banyanshade-software/BleAntRemote/README.md

# BleAntRemote
A bike remote control (to control Garmin GPS, GoPro, etc..) based on nRF5x MCU
