banyanshade-software/BleAntRemote/hardware/board/README.md

# GoPro / Garmin Edge Remote — KiCad Project

## State of this project
- **Schematic** (`gopro_garmin_remote.kicad_sch`): complete and **validated**.
  Generated programmatically then verified with `kicad-cli` (load OK, netlist
  export OK). All expected nets are correctly formed: `VBAT`, `GND`,
  `SWDIO`, `SWCLK`, `GPIO_CAM_ON`, `GPIO_CAM_OFF`, `GPIO_PAGE_R`, `GPIO_PAGE_L`,
  `GPIO_LAP`, `NTC_SENSE`. Only the module's `ANT` and `RESET` pins remain
  intentionally unconnected at this stage.
- **Module footprint** (`RemoteLocal.pretty/E73-2G4M08S1E_hand_solder.kicad_mod`):
  an extended-pad template (hand soldering), referenced by U1. **The radio
  module is not yet chosen** (shortlist in `doc/hardware_notes.md` §9:
  Fanstel BT832 / E73-2G4M08S1E (nRF52833, owned) / E73-2G4M04S1B); this
  footprint/symbol keep their old `E73-2G4M08S1E` filename but are only a
  placeholder to be replaced once the module is picked.
- **PCB**: not generated yet (see "Next steps").

## ⚠️ Out of sync: thermistor removed from the design
`NTC1`, `R1`, and the `NTC_SENSE` net below are from an earlier design
that used an external NTC thermistor for temperature. That was replaced
by the nRF52832's internal die temperature sensor (no external component)
— see `doc/gopro_garmin_remote_specs.md`, "Internal temperature sensor".
This schematic has **not been updated yet** to remove them — treat the
table below as describing the *previous* design for that part, and remove
`NTC1`/`R1`/`NTC_SENSE` during the next schematic edit.

## Schematic components

| Ref. | Description | Connected nets |
|---|---|---|
| U1 | Radio module (custom placeholder symbol, still named `E73-2G4M08S1E`; module TBD — see `doc/hardware_notes.md` §9) | VBAT, GND, SWDIO, SWCLK, GPIO_CAM_ON/OFF, GPIO_PAGE_R/L, GPIO_LAP, NTC_SENSE |
| BT1 | CR2032 coin cell | VBAT, GND |
| C1 | 100µF tantalum (decoupling) | VBAT, GND |
| C2 | 100nF ceramic (HF filtering) | VBAT, GND |
| SW1–SW5 | Push buttons (CAM_ON, CAM_OFF, PAGE_R, PAGE_L, LAP) | GND + dedicated GPIO |
| NTC1 | 10k thermistor | VBAT, NTC_SENSE |
| R1 | 10k fixed resistor (thermistor divider) | NTC_SENSE, GND |
| J1 | 4-pin SWD header | VBAT, SWDIO, SWCLK, GND |

## ⚠️ Points to check before fabrication

1. **Actual module pinout**: the `U1` symbol uses **placeholder pin numbers**
   (1–7, 10–15) that do NOT necessarily match any module's real physical
   pins. Before routing a PCB, pick the module (`doc/hardware_notes.md` §9)
   and re-align these numbers with its real pinout table (the per-module pin
   maps are in §9.7), or reuse a verified library symbol.
2. **Module footprint**: the footprint provided is an **educational template**
   (extended-pad technique demonstrated on 8 pins). It needs to be redone for
   the chosen module's real pads before routing the PCB.
3. **Schematic layout**: the labels are a bit visually cramped (generated by
   script, not by a human in the editor). The electrical connectivity is
   correct, but you'll likely want to rearrange the labels in KiCad for
   readability (Tools > nothing to recompute, just visual comfort).

## Suggested next steps

1. Remove `NTC1`, `R1`, and the `NTC_SENSE` net (superseded by the
   internal temperature sensor — see above).
2. Open `gopro_garmin_remote.kicad_pro` in KiCad 7+, review the schematic on
   screen, rearrange if needed.
3. Pick the module (hardware_notes §9) and complete its real pinout
   (symbol + footprint).
4. Switch to PCB mode (`Tools > Update PCB from Schematic`), place the
   components, route the traces.
5. Add the enclosure outline / mounting holes based on the chosen handlebar
   mount.

## Tools used to generate this project
- `kiutils` (Python) to write a syntactically valid `.kicad_sch`.
- `kicad-cli` 7.0.11 to validate loading and export the netlist/PDF.
- Symbols reused as-is from the standard KiCad libraries:
  `Device:R`, `Device:C`, `Device:Battery_Cell`, `Device:Thermistor_NTC`,
  `Switch:SW_Push`, `Connector_Generic:Conn_01x04`.
