banyanshade-software/BleAntRemote/doc/OtherSimilarRealisations.md

# To be checked

## GoPro command

* [Open GoPro](https://gopro.github.io/OpenGoPro/docs/)

* [github nrf52_gopro_zephyr](https://github.com/Sergey1560/nrf52_gopro_zephyr)
seems similar

## ANT

* [vieux github](https://github.com/Goordey/NRF52/tree/master/sdk/examples/ant/ant_broadcast)

* [ANT/ANT+](https://devzone.nordicsemi.com/f/nordic-q-a/32445/ant-ant-confusion-examples)
https://www.nordicsemi.com/Products/Wireless/ANT/Development-software

* https://www.nordicsemi.com/Products/Wireless/ANT/Development-software
