banyanshade-software/BleAntRemote/hardware/board/gopro_garmin_remote.kicad_sch

## KiCad design hardware/board/gopro_garmin_remote.kicad_sch (2026-08-22)

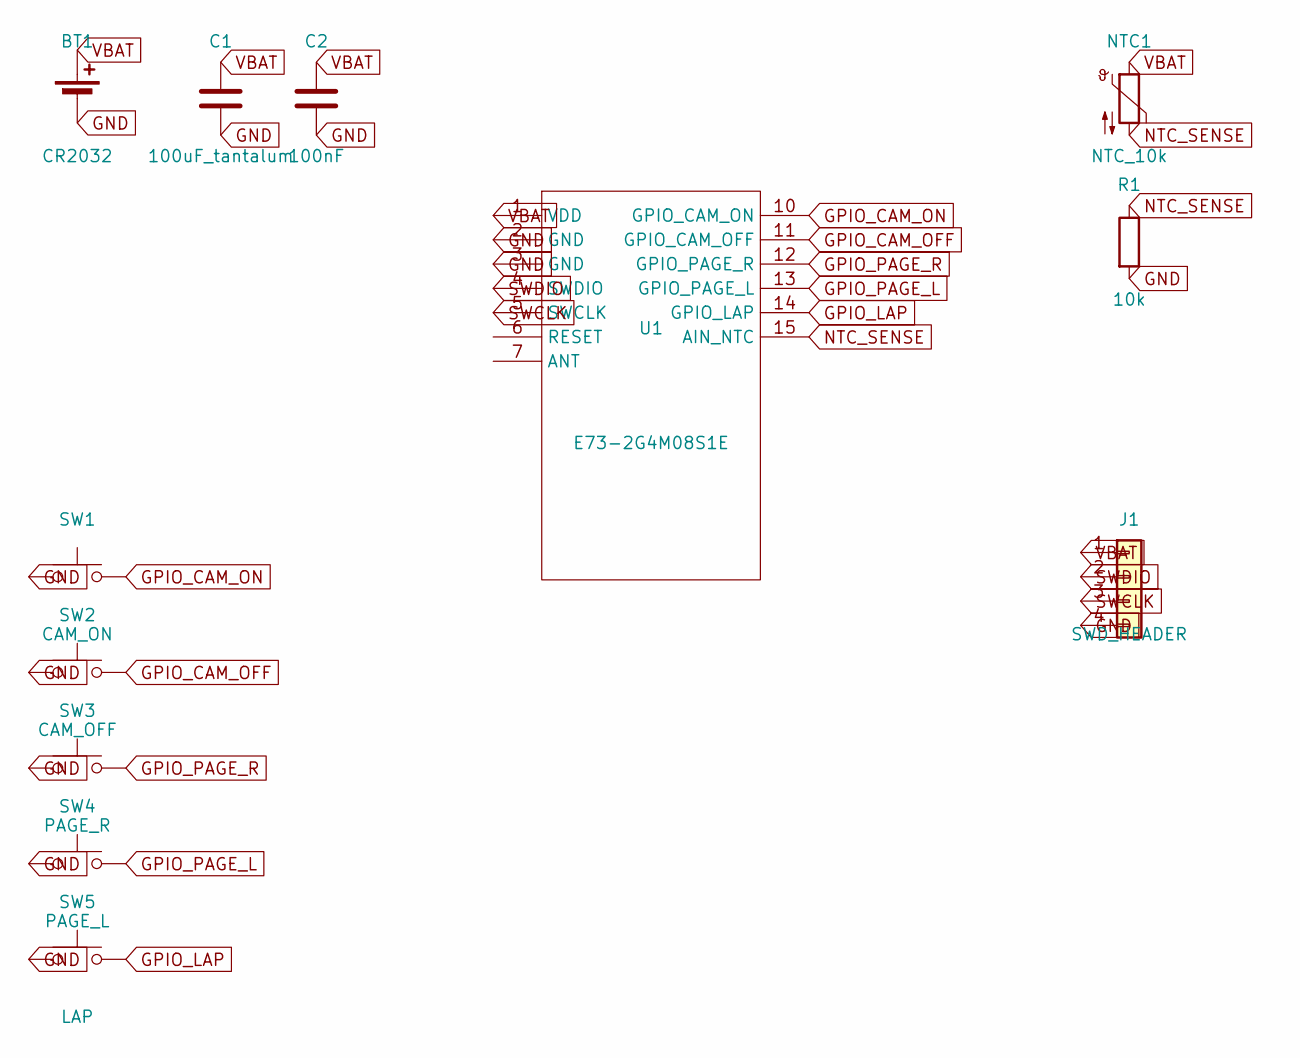
[picture p3: schematic gopro_garmin_remote.kicad_sch]

Parts:
BT1: CR2032
C1: 100uF_tantalum
C2: 100nF
J1: SWD_HEADER
NTC1: NTC_10k
R1: 10k
SW1: CAM_ON
SW2: CAM_OFF
SW3: PAGE_R
SW4: PAGE_L
SW5: LAP
U1: E73-2G4M08S1E; E73-2G4M08S1E_hand_solder

Connections:
GND: BT1.2 (-), C1.2, C2.2, J1.4, R1.2, SW1.1, SW2.1, SW3.1, SW4.1, SW5.1, U1.2 (GND), U1.3 (GND)
GPIO_CAM_OFF: SW2.2, U1.11 (GPIO_CAM_OFF)
GPIO_CAM_ON: SW1.2, U1.10 (GPIO_CAM_ON)
GPIO_LAP: SW5.2, U1.14 (GPIO_LAP)
GPIO_PAGE_L: SW4.2, U1.13 (GPIO_PAGE_L)
GPIO_PAGE_R: SW3.2, U1.12 (GPIO_PAGE_R)
NTC_SENSE: NTC1.2, R1.1, U1.15 (AIN_NTC)
SWCLK: J1.3, U1.5 (SWCLK)
SWDIO: J1.2, U1.4 (SWDIO)
VBAT: BT1.1 (+), C1.1, C2.1, J1.1, NTC1.1, U1.1 (VDD)
