banyanshade-software/BleAntRemote/software/gopro_remote_fw/src/main.c

/*
 * gopro_remote - bring-up firmware for the nRF52840 Dongle
 * ==========================================================
 *
 * This file owns the main finite-state machine: it wakes up on button
 * press, decides which action to run, and dispatches it to the
 * protocol-specific modules. It does not know about BLE or ANT+
 * internals - that logic lives in ble_gopro.[ch] (GoPro over BLE) and
 * ant_garmin.[ch] (Garmin Edge over ANT+, stub for now). temp_sensor.[ch]
 * provides the internal temperature reading; ant_garmin.c owns *when* to
 * read and broadcast it (a bounded, activity-triggered session - see
 * ant_garmin.h). main.c only reports "a button was pressed" via
 * ant_garmin_note_activity(), it does not manage the session itself.
 * This split keeps each radio protocol/sensor independently maintainable
 * and testable, and makes it straightforward to add a new module later
 * (e.g. a BLE peripheral "configuration service" for a companion mobile
 * app) without touching the others.
 *
 * What this firmware does (functional) :
 *   - Scans for and connects to a GoPro (filtering on the BLE service
 *     0xFEA6, advertised by Open GoPro compatible GoPros).
 *   - Performs bonding (secure pairing), required to talk to the
 *     GoPro. Keys are persisted to flash (CONFIG_SETTINGS), so
 *     subsequent connections won't need to re-pair.
 *   - Discovers the GP-0072/73 (Command/Response) and GP-0074/75
 *     (Query/Response) characteristics, subscribes to both.
 *   - Runs a small recording FSM (see the "Recording FSM" comment right
 *     above main()): "Camera ON"/"Camera OFF" (multi-button mode) or
 *     SW1 (mono-button toggle mode) drive it towards REC_ON/REC_OFF;
 *     the shutter=1/0 command is only sent on an actual on<->off
 *     transition, never repeated for an unchanged target, so it can't
 *     double-send the GoPro's confirmation beep. A ~1s status poll
 *     confirms the command took effect and also catches the camera
 *     being started/stopped manually (or disconnecting).
 *   - Buttons are debounced with a simple per-button cooldown.
 *
 * What this firmware does NOT do (to be added later) :
 *   - ANT+ (Garmin page right/left/lap buttons, and the temperature
 *     broadcast) : Nordic's Zephyr-based ANT+ add-on (`sdk-ant`) does
 *     support the nRF52832 used here (no chip change needed - see
 *     doc/gopro_garmin_remote_specs.md, "ANT+ implementation notes"),
 *     but getting ANT+ Adopter/GitHub access to the gated add-on repo
 *     and integrating its west workspace hasn't been done yet. Not
 *     included here. The Garmin buttons and the temperature broadcast
 *     are wired to stubs (see
 *     ant_garmin.c) in the meantime. The 3 Garmin buttons themselves
 *     are not wired to GPIOs/actions yet either (see README).
 *   - Fine-grained power management (System OFF between connections) :
 *     the dongle is USB-powered, so not critical for testing, but
 *     needs to be revisited for the final CR2032 version. Note this
 *     also now needs to account for the temperature broadcast session
 *     (see ant_garmin.h): while a session is active (up to
 *     TEMP_SESSION_DURATION_MIN minutes after the last button press),
 *     the MCU must wake periodically via its RTC/kernel timer to send
 *     a reading, so it cannot use full System OFF sleep during that
 *     window - only once the session ends does it go back to pure
 *     button-interrupt wake-up.
 *   - Battery voltage reading (ADC) : not wired on the bare dongle, to
 *     be added with the real enclosure. (Ambient temperature no longer
 *     needs a thermistor/ADC - see temp_sensor.c, which reads the
 *     nRF52's internal die temperature sensor instead.)
 *
 * Button GPIO pinout : see boards/nrf52840dongle_nrf52840.overlay
 */

#include <zephyr/kernel.h>
#include <zephyr/device.h>
#include <zephyr/devicetree.h>
#include <zephyr/drivers/gpio.h>
#include <zephyr/drivers/watchdog.h>
#include <zephyr/drivers/hwinfo.h>
#include <zephyr/logging/log.h>
#include <zephyr/settings/settings.h>

#include "ble_gopro.h"
#include "ant_garmin.h"
#include "temp_sensor.h"

//LOG_MODULE_REGISTER(gopro_remote, LOG_LEVEL_INF);
LOG_MODULE_REGISTER(gopro_remote, LOG_LEVEL_DBG);

/* -------------------------------------------------------------------
 * Buttons (gpio-keys via devicetree)
 * ------------------------------------------------------------------- */
#define BTN_CAM_ON_NODE  DT_ALIAS(sw_cam_on)
#define BTN_CAM_OFF_NODE DT_ALIAS(sw_cam_off)
#define BTN_SW1_NODE     DT_ALIAS(sw1)

/* Action queue processed outside of interrupt context. STATUS_TICK/
 * STATUS_RESULT are not button presses - see the status timer and
 * ble_gopro status callback further below - but they go through the
 * same queue so the FSM in main() stays single-threaded. */
enum rmt_event {
	EVENT_NONE = 0,
	EVENT_CAM_ON = 1,
	EVENT_CAM_OFF = 2,
	EVENT_BTN_SW1 = 3,
	EVENT_STATUS_TICK = 4,
	EVENT_STATUS_RES_CAM_ON = 5,
	EVENT_STATUS_RES_CAM_OFF = 6,
	EVENT_CAM_DISCOVERED = 7	, /* GoPro connected but not recording (e.g. just powered on) */
	EVENT_ANT_NEXT_PAGE = 8, /* SW1 short press -> ANT+ Controls "next page" (Menu Down) */
	EVENT_ANT_CUSTOM = 9,    /* SW1 long  press -> ANT+ Controls Custom (0x8000) */
};


 struct remote_msg {
        enum rmt_event action;
 };

K_MSGQ_DEFINE(action_msgq, sizeof(struct remote_msg), 8, 4);

/* -------------------------------------------------------------------
 * Buttons : ISR -> just posts an event to the queue, all the (BLE)
 * work happens in the main loop (normal thread).
 * ------------------------------------------------------------------- */



#define DEBOUNCE_MS 200
/* SW1 single-button: held >= LONG_PRESS_MS is a long press (Home),
 * otherwise a short press (next page). */
#define LONG_PRESS_MS 600
struct button {
	const struct gpio_dt_spec spec;
	enum rmt_event action;
	const char *name;
	struct gpio_callback cb;
	int64_t last_press_ms;
};

static   struct button btn_cam_on = {
	.spec = GPIO_DT_SPEC_GET(BTN_CAM_ON_NODE, gpios),
	.action = EVENT_CAM_ON,
	.name = "CAM_ON",
};
static  struct button btn_cam_off = {
	.spec = GPIO_DT_SPEC_GET(BTN_CAM_OFF_NODE, gpios),
	.action = EVENT_CAM_OFF,
	.name = "CAM_OFF",
};
static  struct button btn_sw1 = {
	.spec = GPIO_DT_SPEC_GET(BTN_SW1_NODE, gpios),
	.action = EVENT_BTN_SW1,
	.name = "SW1",
};

static void btn_isr(const struct device *dev, struct gpio_callback *cb, uint32_t pins)
{
	struct button *btn = CONTAINER_OF(cb, struct button, cb);
	int64_t now = k_uptime_get();

	if (now - btn->last_press_ms < DEBOUNCE_MS) {
		return; /* bounce (or a too-fast repeat press): ignore */
	}
	btn->last_press_ms = now;

	LOG_INF("Button %s pressed", btn->name);
	struct remote_msg msg = { .action = btn->action };

	k_msgq_put(&action_msgq, &msg, K_NO_WAIT);
}

/*
 * SW1 is the dongle's single user button. It needs short-vs-long press
 * discrimination:
 *   short press (< LONG_PRESS_MS) -> EVENT_ANT_NEXT_PAGE (Menu Down)
 *   long  press (>= LONG_PRESS_MS) -> EVENT_ANT_CUSTOM   (Custom 0x8000)
 *
 * Reading the pin level directly in the edge ISR is unreliable: contact
 * bounce produces bursts of edges, and a stray release edge used to clear
 * the press timestamp so the real release was dropped (long press missed).
 *
 * Instead the ISR only wakes a polling work item, which samples the button
 * every SW1_POLL_MS with a small debounce filter. The long press is emitted
 * as soon as the hold crosses LONG_PRESS_MS (even if the release bounces),
 * and the short press is emitted on a clean release. The ANT+ command is
 * sent from the main loop, not here.
 */
#define SW1_POLL_MS        20
#define SW1_STABLE_SAMPLES 2  /* consecutive equal reads to accept a level */

static void sw1_work_fn(struct k_work *work);
static K_WORK_DELAYABLE_DEFINE(sw1_work, sw1_work_fn);

static bool    sw1_down;        /* debounced pressed state */
static bool    sw1_long_fired;  /* HOME already emitted for this hold */
static int64_t sw1_down_ms;     /* uptime at debounced press */
static bool    sw1_raw_last;    /* last raw sample */
static int     sw1_stable_cnt;  /* consecutive equal raw samples */

static void sw1_post(enum rmt_event ev)
{
	struct remote_msg msg = { .action = ev };
	k_msgq_put(&action_msgq, &msg, K_NO_WAIT);
}

static void sw1_work_fn(struct k_work *work)
{
	ARG_UNUSED(work);
	bool raw = (gpio_pin_get_dt(&btn_sw1.spec) == 1); /* 1 = pressed */

	/* Debounce: require SW1_STABLE_SAMPLES equal raw reads in a row. */
	if (raw == sw1_raw_last) {
		if (sw1_stable_cnt < SW1_STABLE_SAMPLES) {
			sw1_stable_cnt++;
		}
	} else {
		sw1_raw_last = raw;
		sw1_stable_cnt = 0;
	}

	if (sw1_stable_cnt >= SW1_STABLE_SAMPLES && raw != sw1_down) {
		sw1_down = raw; /* debounced edge */
		if (sw1_down) {
			sw1_down_ms = k_uptime_get();
			sw1_long_fired = false;
		} else if (!sw1_long_fired) {
			sw1_post(EVENT_ANT_NEXT_PAGE); /* clean short release */
		}
	}

	/* Long press fires at the threshold, while still held. */
	if (sw1_down && !sw1_long_fired &&
	    (k_uptime_get() - sw1_down_ms) >= LONG_PRESS_MS) {
		sw1_long_fired = true;
		sw1_post(EVENT_ANT_CUSTOM);
	}

	/* Keep polling while pressed or not yet settled in the released state. */
	if (sw1_down || raw || sw1_stable_cnt < SW1_STABLE_SAMPLES) {
		k_work_schedule(&sw1_work, K_MSEC(SW1_POLL_MS));
	}
}

static void sw1_isr(const struct device *dev, struct gpio_callback *cb, uint32_t pins)
{
	ARG_UNUSED(dev);
	ARG_UNUSED(cb);
	ARG_UNUSED(pins);
	/* Just wake the poller; all logic lives in sw1_work_fn. */
	k_work_schedule(&sw1_work, K_NO_WAIT);
}

static int setup_sw1_button(void)
{
	int err;

	if (!gpio_is_ready_dt(&btn_sw1.spec)) {
		LOG_ERR("Button %s GPIO not ready", btn_sw1.name);
		return -ENODEV;
	}

	err = gpio_pin_configure_dt(&btn_sw1.spec, GPIO_INPUT);
	err |= gpio_pin_interrupt_configure_dt(&btn_sw1.spec, GPIO_INT_EDGE_BOTH);
	if (err) {
		LOG_ERR("Button %s GPIO configuration failed (%d)", btn_sw1.name, err);
		return err;
	}

	gpio_init_callback(&btn_sw1.cb, sw1_isr, BIT(btn_sw1.spec.pin));
	gpio_add_callback(btn_sw1.spec.port, &btn_sw1.cb);
	return 0;
}

static int setup_one_button( struct button *btn)
{
	int err;

	if (!gpio_is_ready_dt(&btn->spec)) {
		LOG_ERR("Button %s GPIO not ready", btn->name);
		return -ENODEV;
	}

	err = gpio_pin_configure_dt(&btn->spec, GPIO_INPUT);
	err |= gpio_pin_interrupt_configure_dt(&btn->spec, GPIO_INT_EDGE_TO_ACTIVE);
	if (err) {
		LOG_ERR("Button %s GPIO configuration failed (%d)", btn->name, err);
		return err;
	}

	gpio_init_callback(&btn->cb, btn_isr, BIT(btn->spec.pin));
	gpio_add_callback(btn->spec.port, &btn->cb);
	return 0;
}



static int setup_buttons(void)
{
	int err  = 0;
	err |= setup_one_button(&btn_cam_on);
	err |= setup_one_button(&btn_cam_off);
	err |= setup_sw1_button(); /* SW1: short/long press -> ANT+ commands */
	return err;
}

/* -------------------------------------------------------------------
 * ~1s status poll timer and ble_gopro status callback: both just post
 * to the action queue, all the FSM logic lives in main()'s loop below.
 * k_timer expiry and the BT RX thread are not the main thread, so this
 * is all they're allowed to do.
 * ------------------------------------------------------------------- */


static void status_timer_handler(struct k_timer *timer)
{
	struct remote_msg msg = { .action = EVENT_STATUS_TICK };
	//LOG_DBG("TTT isr");
	k_msgq_put(&action_msgq, &msg, K_NO_WAIT);
}


K_TIMER_DEFINE(status_timer, status_timer_handler, NULL);

static void on_gopro_status(enum gopro_rec_state status)
{
	LOG_DBG("on_gopro_status: status=%d", status);
	struct remote_msg msg = { 0 };
	switch (status) {
		case GOPRO_REC_STARTED:
			msg.action = EVENT_STATUS_RES_CAM_ON;
			break;
		case GOPRO_REC_STOPPED:
			msg.action = EVENT_STATUS_RES_CAM_OFF;
			break;
		case GOPRO_REC_DISCOVERED:
			msg.action = EVENT_CAM_DISCOVERED;
			break;
		case GOPRO_REC_UNKNOWN:
			LOG_DBG("on_gopro_status: GOPRO_REC_UNKNOWN - ignoring");
			return;
		default:
			LOG_ERR("on_gopro_status: unknown status %d", status);
			return;
	}
	k_msgq_put(&action_msgq, &msg, K_NO_WAIT);
}

/*
 * Recording FSM states (the whole FSM lives in main()'s loop below):
 *   REC_OFF      - not recording, idle.
 *   REC_ON_SENT  - "start recording" sent, waiting for the camera to
 *                  confirm it (via the ~1s status poll).
 *   REC_ON       - camera confirmed it is recording.
 *   REC_OFF_SENT - "stop recording" sent, waiting for confirmation.
 * No other state is needed: ON_SENT/OFF_SENT only exist to remember
 * "a command is outstanding" so a same-direction button press can be
 * ignored (that's what stops the BLE "start recording" command from
 * ever being sent twice in a row, which is what makes the camera beep
 * an extra time) - REC_ON/REC_ON_SENT together mean "target: on",
 * REC_OFF/REC_OFF_SENT together mean "target: off".
 */
enum rec_state {
	REC_UNKNOWN = 0,
	REC_OFF,
	REC_ON_SENT,
	REC_ON,
	REC_OFF_SENT,
};

/* from blinky */


/* 1000 msec = 1 sec */
#define SLEEP_TIME_MS   1000

/* The devicetree node identifier for the "led0" alias. */
#define LED0_NODE DT_ALIAS(led0)

/*
 * A build error on this line means your board is unsupported.
 * See the sample documentation for information on how to fix this.
 */
static const struct gpio_dt_spec led = GPIO_DT_SPEC_GET(LED0_NODE, gpios);

/* Hardware watchdog: an independent peripheral that keeps counting
 * down even if the CPU truly locks up (fault-in-fault, IRQs wedged
 * off, etc.) - the one thing that can still recover us and tell us
 * something when even the fatal-error handler can't print anything.
 * Armed with a long window, then deliberately NOT fed across the
 * ble_gopro_init()/bt_enable() call: if that call locks up, the
 * watchdog fires on its own a few seconds later and resets the chip. */
static const struct device *const wdt = DEVICE_DT_GET(DT_ALIAS(watchdog0));
static int wdt_channel_id = -1;

static void log_reset_cause(void)
{
	uint32_t cause = 0;

	if (hwinfo_get_reset_cause(&cause) == 0) {
		LOG_INF("Reset cause: 0x%08x%s", cause,
			(cause & RESET_WATCHDOG) ? " <-- WATCHDOG: previous boot locked up here!" : "");
		hwinfo_clear_reset_cause();
	} else {
		LOG_WRN("hwinfo_get_reset_cause() failed");
	}
}

static void watchdog_arm(void)
{
	if (!device_is_ready(wdt)) {
		LOG_WRN("Watchdog device not ready - no lockup recovery this run");
		return;
	}

	struct wdt_timeout_cfg wdt_cfg = {
		.window.min = 0,
		.window.max = 5000, /* must be fed at least every 5s */
		.callback = NULL,
		.flags = WDT_FLAG_RESET_SOC,
	};

	wdt_channel_id = wdt_install_timeout(wdt, &wdt_cfg);
	if (wdt_channel_id < 0) {
		LOG_ERR("wdt_install_timeout() failed (%d)", wdt_channel_id);
		return;
	}
	if (wdt_setup(wdt, 0) != 0) {
		LOG_ERR("wdt_setup() failed");
		wdt_channel_id = -1;
	}
}

static void watchdog_feed(void)
{
	if (wdt_channel_id >= 0) {
		wdt_feed(wdt, wdt_channel_id);
	}
}

/* Heartbeat: fast LED toggle while a blocking init call (e.g.
 * ble_gopro_init()/bt_enable()) is in progress. No debugger/console
 * available on the bare dongle, so this is how we tell "it's still
 * alive and hasn't returned yet" from "it froze/hard-faulted right
 * here": if this stops toggling and NEVER resumes (no fatal() blink
 * pattern ever starts either), the crash happened inside that call. */
static void heartbeat_handler(struct k_timer *timer)
{
	gpio_pin_toggle_dt(&led);
}
K_TIMER_DEFINE(heartbeat_timer, heartbeat_handler, NULL);

/* Halts and blinks the LED abs(code) times (capped), pausing between
 * repeats, so the code can be read off by counting blinks - no
 * debugger/console needed. Distinguishable from the heartbeat above
 * because of the long pause between bursts. */
static void fatal(int code)
{
	LOG_ERR("Fatal error %d - halting", code);

	int blinks = code < 0 ? -code : code;
	if (blinks == 0) {
		blinks = 1;
	}
	if (blinks > 20) {
		blinks = 20;
	}

	while (1) {
		for (int i = 0; i < blinks; i++) {
			watchdog_feed(); /* fatal() is a deliberate halt, not a
					   * real lockup - don't let the watchdog
					   * reset us out of it. */
			gpio_pin_set_dt(&led, 1);
			k_msleep(200);
			gpio_pin_set_dt(&led, 0);
			k_msleep(200);
		}
		k_msleep(1500);
	}
}
/* -------------------------------------------------------------------
 * main - button/action finite-state machine
 * ------------------------------------------------------------------- */
int main(void)
{
	int err;

	log_reset_cause();

	LOG_INF("=== GoPro Remote (nRF52840 Dongle) - starting ===");

	if (!gpio_is_ready_dt(&led)) {
		LOG_ERR("LED GPIO not ready");
		fatal(1);
	}
	err = gpio_pin_configure_dt(&led, GPIO_OUTPUT_INACTIVE);
	if (err < 0) {
		LOG_ERR("LED GPIO configuration failed (%d)", err);
		fatal(2);
	}

	if ((0)) watchdog_arm();

	/* LED toggles here independently of LOG_INF, so it keeps proving
	 * the CPU is alive even if the console/USB link itself stalls
	 * (e.g. CDC ACM backpressure) and stops printing. */
	const int startup_blink_count = 2;	
	for (int i=0; i<startup_blink_count; i++) {
		watchdog_feed();
		gpio_pin_toggle_dt(&led);
		LOG_INF("=== GoPro Remote (nRF52840 Dongle) - starting (%d/%d) ***", i, startup_blink_count);
		k_msleep(1000);
	}
	LOG_INF("compile date: %s", __DATE__);


	
	LOG_INF("=== config BLE---->");

/*
	err = settings_subsys_init();
	if (err) {
		LOG_ERR("settings_subsys_init() failed (%d)", err);
		fatal(err);
	}
*/	
	watchdog_feed(); /* last feed before the risky call - deliberately
			   * not fed again until it returns, so a lockup in
			   * here forces a watchdog reset within ~5s. */
	k_timer_start(&heartbeat_timer, K_MSEC(150), K_MSEC(150));
	err = ble_gopro_init();
	LOG_INF("=== config BLE done, err=%d", err);

	k_timer_stop(&heartbeat_timer);
	watchdog_feed();

	if (err) {
		LOG_ERR("ble_gopro_init() failed (%d)", err);
		fatal(err);
	}
	//fatal(420);

	err = setup_buttons();
	if (err) {
		LOG_ERR("Aborting: buttons not functional");
		fatal(3);
	}
	LOG_INF("**** ANT init");
	ant_garmin_init();

	LOG_INF("**** temp_sensor init");

	err = temp_sensor_init();
	if (err) {
		LOG_WRN("Internal temperature sensor unavailable (%d)", err);
	}
	LOG_INF("**** ANT init done");


	ble_gopro_set_status_cb(on_gopro_status);
	//k_timer_init(&status_timer, status_timer_handler, NULL);
	//LOG_DBG("TTT Starting status timer (1s period)");
	//k_timer_start(&status_timer, K_SECONDS(1), K_SECONDS(1));

	enum rec_state rec_state = REC_UNKNOWN; /* start unknown, will be set by the first status poll */
	bool status_query_sent = false; /* at most one status query outstanding */

	/* Main loop: wait for a button/status action and run the
	 * recording FSM. Each protocol module (ble_gopro, ant_garmin)
	 * manages its own connection/reconnection state internally. */
	struct remote_msg msg;
	while (1) {
		gpio_pin_toggle_dt(&led);

		k_msgq_get(&action_msgq, &msg, K_FOREVER);

		enum rmt_event action = msg.action;

		if (EVENT_BTN_SW1 == action) {
			switch (rec_state) {
				case REC_UNKNOWN:	//FALLTHRU
				case REC_ON_SENT:	//FALLTHRU
				case REC_OFF_SENT:	//FALLTHRU
				default:
					/* ignore button presses until we know the camera's state (via the status poll) */
					break;
				case REC_OFF:
					action = EVENT_CAM_ON;
					break;	
				case REC_ON:
					action = EVENT_CAM_OFF;
					break;
			}
		}
		LOG_DBG("FSM: event %d, rec_state %d", action, rec_state);
		switch (action) {
		case EVENT_CAM_DISCOVERED:
			LOG_INF("======= GoPro discovered (GOPRO_REC_DISCOVERED)");
			switch (rec_state) {
				case REC_UNKNOWN:
					if ((0)) {
						LOG_DBG("CAM_DISCOVERED in REC_UNKNOWN: start status ble_gopro_query_status()");
						status_query_sent = true;
						ble_gopro_query_status();
					} else {
						LOG_DBG("CAM_DISCOVERED in REC_UNKNOWN");
					}
					k_timer_start(&status_timer, K_SECONDS(1), K_SECONDS(1));
					break;
				default:
					LOG_WRN("CAM_DISCOVERED while in state %d: ignore", rec_state);
					break;
			}	
			break;
		case EVENT_CAM_ON:
			switch (rec_state) {
				case REC_OFF_SENT:
					k_timer_stop(&status_timer);
					status_query_sent = false; /* poll right away next tick */
					//FALLTHRU
				case REC_OFF:
					ble_gopro_send_shutter(true);
					rec_state = REC_ON_SENT;
					status_query_sent = false; /* poll right away next tick */
					k_timer_start(&status_timer, K_SECONDS(1), K_SECONDS(1));
					break;
				
				default:
					// ignore button in any other states
					LOG_INF("BAD STATE FOR CAM_ON: %d -> REC_ON_SENT", rec_state);
					break;
			}
			break;

		case EVENT_CAM_OFF:
			switch (rec_state) {
			case REC_ON_SENT:
					k_timer_stop(&status_timer);
					status_query_sent = false; /* poll right away next tick */
					//FALLTHRU
				case REC_ON:
					ble_gopro_send_shutter(false);
					rec_state = REC_OFF_SENT;
					status_query_sent = false; /* poll right away next tick */
					k_timer_start(&status_timer, K_SECONDS(1), K_SECONDS(1));
					break;
				default:
					// ignore button in any other states
					LOG_INF("BAD STATE FOR CAM_OFF: %d -> REC_OFF_SENT", rec_state);
					break;
			}
			break;
		case EVENT_STATUS_TICK:
			if (rec_state == REC_OFF) {
				LOG_ERR("STATUS_TICK while REC_OFF: shouldn't have polled, stopping timer");	
				k_timer_stop(&status_timer);
				break;
			}
				
			if (!status_query_sent) {
				LOG_DBG("STATUS_TICK: sending status ble_gopro_query_status()");
				ble_gopro_query_status();
				status_query_sent = true;
			} else if (rec_state == REC_UNKNOWN	) {
				LOG_DBG("STATUS_TICK while REC_UNKNOWN ignoring status_query_sent=%d", status_query_sent);
				status_query_sent = true;
				ble_gopro_query_status();
			} else {
				LOG_DBG("STATUS_TICK while status_query_sent: ignore");
			}
			break;
		case EVENT_STATUS_RES_CAM_ON:
			if (!status_query_sent) {
				LOG_ERR("STATUS_RES_CAM_ON while !status_query_sent: ignore ressponse");
				//k_timer_stop(&status_timer);
				break;
			}
			switch(rec_state) {
				case REC_UNKNOWN:
					LOG_DBG("STATUS_RES_CAM_ON while REC_UNKNOWN: set to REC_ON");
					rec_state = REC_ON;
					break;
				case REC_ON_SENT:
					rec_state = REC_ON;
					break;
				case REC_OFF_SENT:
					LOG_ERR("STATUS_RES_CAM_ON while REC_OFF_SENT");
					break;
				default:
					LOG_ERR("STATUS_RES_CAM_ON while in state %d: shouldn't have polled, stopping timer", rec_state);
					k_timer_stop(&status_timer);
					break;
			}
	
		case EVENT_STATUS_RES_CAM_OFF:
			if (!status_query_sent) {
				LOG_ERR("STATUS_RES_CAM_OFF while !status_query_sent: ignore ressponse");
				//k_timer_stop(&status_timer);
				break;
			}			
			switch(rec_state) {
				case REC_UNKNOWN:
					LOG_DBG("STATUS_RES_CAM_OFF while REC_UNKNOWN: set to REC_OFF");
					rec_state = REC_OFF;
					k_timer_stop(&status_timer);
					break;
				case REC_OFF_SENT:
					rec_state = REC_OFF;
					k_timer_stop(&status_timer);
					break;
				case REC_ON_SENT:
					LOG_ERR("STATUS_RES_CAM_OFF while REC_ON_SENT");
					break;
				default:
					LOG_ERR("STATUS_RES_CAM_OFF while in state %d: shouldn't have polled, stopping timer", rec_state);
					k_timer_stop(&status_timer);
					break;
			}
			break;
		case EVENT_ANT_NEXT_PAGE:
			LOG_INF("SW1 short press -> ANT+ next page");
			ant_garmin_note_activity();
			ant_garmin_handle_button("next_page");
			break;
		case EVENT_ANT_CUSTOM:
			LOG_INF("SW1 long press -> ANT+ custom (0x8000)");
			ant_garmin_note_activity();
			ant_garmin_handle_button("custom");
			break;
		default:
			LOG_ERR("Unknown event %d", msg.action);
			break;
		}
	}

	return 0;
}
