banyanshade-software/BleAntRemote/(commit log)

2026-08-22 claude generated spec and unreviewed schematic
    [gopro_garmin_remote.kicad_sch]
2026-08-26 Translate docs/comments to English; document mobile-app BLE config requirement
    - Translate all Markdown docs (README files, specs) and firmware code
    comments/log strings from French to English, no logic changes.
    - Rename doc/telecommande_gopro_garmin_specs.md -> doc/gopro_garmin_remote_specs.md.
    - Update the specs doc to capture the new requirement: the device must be
    configurable from a mobile app over BLE. Removes the outdated "no remote
    config" exclusion and adds a draft technical section (BLE peripheral
    Configuration Service) with the transport/session/parameters explicitly
    flagged as still to be defined and unimplemented in firmware.
2026-08-26 Split firmware into BLE/ANT/FSM modules, add modularity requirement to specs
    - doc: add a "Maintainability & modularity" requirement to the technical
    specs, describing the per-protocol module split and its rationale.
    - firmware: split main.c into three modules:
    - main.c: button GPIO/interrupt setup, action queue, main FSM dispatch.
    - ble_gopro.[ch]: GoPro BLE central-role driver (scan, bonding, GATT
    discovery, shutter command) - self-contained, auto re-scans on
    disconnect and auto-subscribes once discovery completes instead of
    being polled from the main loop.
    - ant_garmin.[ch]: ANT+/Garmin stub, unchanged behavior, new interface.
    - CMakeLists.txt: build the two new source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
2026-08-26 Use ANT+ for both Garmin remote commands and temperature broadcast
    - specs: replace the external NTC-thermistor plan with the nRF52832's
    internal die temperature sensor, broadcast over ANT+ (alongside the
    existing Generic Controls remote commands) so it shows up as a Garmin
    Edge data field. Flags the open design questions this creates: exact
    ANT+ profile (expected: Environment Sensor), whether it needs its own
    channel, opportunistic-vs-periodic broadcast timing and its battery
    impact, and internal-sensor accuracy vs. true ambient temperature.
    Removes NTC1/R1 from the BOM.
    - firmware: add temp_sensor.[ch], reading the nRF52's internal TEMP
    peripheral via Zephyr's sensor API (S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
    [ant_garmin.c, ant_garmin.h, main.c, temp_sensor.c, temp_sensor.h]
2026-08-26 Make temperature broadcast an activity-triggered, bounded ANT+ session
    Resolves the previously-open "broadcast timing" question with a
    concrete decided behavior:
    - Idle by default: no ANT+ temperature activity at all until a button
    is pressed.
    - Any button press (camera or Garmin) arms a session: a reading is
    broadcast every 5 minutes (TEMP_BROADCAST_INTERVAL_MIN) for up to 30
    minutes (TEMP_SESSION_DURATION_MIN) since the *last* press - both are
    tunable example defaults, defined in ant_garmin.c.
    - A further button press during an active session resets the 30-minute
    window rather than stacking a second session.
    - After 30 minutes of inactivity, the session ends and the sub-system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
    [ant_garmin.c, ant_garmin.h, main.c]
2026-08-26 Add Zephyr API reference section for readers new to Zephyr (e.g. FreeRTOS)
    Adds a "5. Zephyr API reference" section at the end of the specs doc,
    built from the actual calls used across main.c/ble_gopro.c/ant_garmin.c/
    temp_sensor.c: kernel primitives (k_msgq, k_timer, k_work, with an
    explicit callout that k_timer expiry runs in ISR context unlike
    FreeRTOS's Timer Daemon task - the reason temp_broadcast_timer defers to
    a k_work item), devicetree/device model, GPIO, logging, the sensor
    driver API, settings/NVS, and the BLE host API - each with where it's
    used in this codebase and, where one exists, the closest FreeRTOS
    analogue.
2026-08-26 Add ANT+ primer and correct implementation assumptions from research
    - Add a ~1-page "ANT+ primer" section to the specs doc for readers new
    to ANT+: channels vs. BLE connections, master/slave, message types
    (broadcast/acknowledged/burst), device profiles, why ANT+ is used for
    the Garmin side.
    - Research (web search against Nordic/ANT+ Alliance public sources)
    surfaced a real blocker before any ANT+ code can be written: the
    nRF52832 used in this project is not supported by Nordic's Zephyr-
    based ANT+ add-on (only nRF52840/nRF5340 are) - ANT+ on this chip
    requires the older, separate nRF5 SDK (S212/S332 SoftDevice), a
    different toolchain from the Zephyr one the rest of this fir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
    [ant_garmin.h, main.c]
2026-08-26 Decide MCU move to nRF52840 for ANT+ support, update docs/BOM/comments
    Following the ANT+ toolchain research and the user's choice to move to
    a chip supported by Zephyr's ANT+ add-on rather than fall back to the
    older nRF5 SDK:
    - doc: mark the MCU decision (nRF52840, chosen over nRF5340 for
    architectural continuity - same single-core Cortex-M4F family as the
    nRF52832, and matches the nRF52840 Dongle already used for BLE
    prototyping) in "MCU / radio", "ANT+ implementation notes" (options
    list updated to show what was chosen and why), "PCB", "Development
    tooling", and the BOM (U1 now flagged as an unsourced nRF52840
    module). Open points updated to track what's still needed: sourci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
2026-08-26 Revert "Decide MCU move to nRF52840 for ANT+ support, update docs/BOM/comments"
    This reverts commit 6767163682a4018553cf150c328beab54955be47.
    [ant_garmin.h, main.c, temp_sensor.h]
2026-08-26 Correct ANT+ chip finding: nRF52832 IS supported, support both chips
    Follow-up research corrected the earlier finding: Nordic's Zephyr-based
    ANT+ add-on (sdk-ant) added nRF52832 support back via a newer "Add-on"
    deployment model (nRF Connect SDK v2.9.2+, sdk-ant v2.0.0+) - the
    "nRF52840/nRF5340 only" finding was accurate for the older "Manifest"
    model but is now outdated. An official Nordic sample ("ANT and
    Bluetooth LE Heart Rate Monitor Relay") confirms concurrent BLE+ANT+ on
    the plain nRF52 DK (nRF52832), directly matching this project's needs.
    - Revert the "move to nRF52840" decision: nRF52832 is the primary
    target again (existing KiCad schematic/BOM, no PCB rework needed).
    nRF52840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
    [ant_garmin.h, main.c, temp_sensor.h]
2026-08-26 Corroborate ANT+ access gate via public sdk-nrf repo (no archives used)
    Follow-up check of nrfconnect/sdk-nrf (the main, public SDK repo, as
    opposed to the gated ant-nrfconnect/sdk-ant) confirms rather than
    changes the prior finding:
    - sdk-nrf's own west.yml (checked on main and the v2.9.2 tag directly)
    has zero reference to ANT+/sdk-ant - this project's existing BLE
    manifest has nothing to hook into; a separate west workspace really
    is required.
    - Nordic's own current SDK docs don't mention ANT/ANT+ for the nRF52 at
    all; an older v2.4.4 doc page explicitly said "the nRF Connect SDK
    does not support ANT" (true for that version, superseded since by the
    separate sdk-ant add-on).
    -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
2026-08-26 on progress ble button fsm
2026-10-12 ant: repartir sur une base ANT+ saine (clone du sample bsc_tx)
    Remplace l'implémentation ANT cassée (section partielle incompilable +
    ancien code Environment/température en #if 0 + garbage en fin de fichier)
    par un clone fidèle du sample sdk-ant ant_plus/ant_bsc/bsc_tx : capteur
    ANT+ Bike Speed & Cadence avec simulateur en mode AUTO.
    - ant_garmin.c : structure identique au main.c du sample (config canal/
    profil, event handler BSC, simulateur, profile_setup, ant_stack_setup,
    timer operating-time). Le main() du sample est exposé via
    ant_garmin_init() (main.c garde le vrai main()). Constantes canal/produit
    en #define locaux reprenant les défauts du Kconfig du sample (pas de
    Kco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
2026-10-14 ant remote: commandes officielles (Table 9-8) + bouton SW1 court/long
    - ant_garmin (REMOTE): codes de commande Generic Command page 0x49 alignés
    sur la Table 9-8 du profil ANT+ Controls rev 2.0 (Menu Up/Down/Select/Back,
    Home, Start/Stop/Reset/Length, Lap, Custom). Mapping bouton: next_page ->
    Menu Down, home -> Home, lap -> Lap. Auto-test de bring-up désactivé
    (REMOTE_AUTOTEST=0), remplacé par le vrai bouton.
    - main.c: bouton SW1 unique du dongle avec détection appui court/long robuste
    (débounce par polling, Home émis dès le seuil 600 ms). Appui court -> next
    page (Menu Down), appui long -> home. Nouveaux événements EVENT_ANT_NEXT_PAGE
    / EVENT_ANT_HOME traités dans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
2026-10-14 ant remote: diag Command Status (page 70/71) + bouton long = Custom
    - ant_garmin (REMOTE): après chaque commande, envoie la Request Data Page
    0x46 pour demander la Command Status page 0x47 de l'Edge, et logge le
    statut décodé (Pass/Fail/NotSupported/Rejected/Pending) + seq + command
    number renvoyé. Permet de savoir si l'Edge honore une commande.
    Diagnostic ayant servi à établir que l'Edge ne supporte PAS Home/Menu
    Back/Select/Reset ; supportées: Menu Up/Down, Start, Stop, Lap, Custom.
    - Appui long SW1 -> Custom (0x8000) au lieu de Home (NotSupported). Sur cet
    Edge, Custom = toggle Start/Stop du chrono. Appui court reste Menu Down
    (page suivante). main.c: EVENT_ANT_HOME r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
2026-10-15 ant remote: fin du balayage custom + chainage 0x8000 -> page suivante
    - Balayage diagnostic desactive (REMOTE_SWEEP 0): sur cet Edge seuls
    0x8000 et 0x8001 repondent (pas NotSupported); code garde derriere #if.
    - Appui long = 0x8000 (CTRL_CMD_CUSTOM) de nouveau (fin du test 0x8001).
    - Nouveau define optionnel REMOTE_CUSTOM_CHAIN_NEXT: apres 0x8000, envoie
    un "page suivante" (Menu Down) ~400ms plus tard pour atterrir sur
    l'ecran juste apres celui vise par 0x8000 (ex: compteur apres la carte).
2026-10-15 ant remote: fiabilise le chainage custom (coupe le diag, delai 600ms)
    L'appui long (0x8000 puis "page suivante") ratait parfois: on empilait
    plusieurs messages acknowledged qui se telescopaient sur le canal.
    - REMOTE_STATUS_DIAG 0: plus de requete Command Status (0x47) apres
    chaque commande (c'etait du diagnostic, la map de support est connue).
    Un appui = un seul message acknowledged propre. Le code de requete de
    statut est gate derriere #if REMOTE_STATUS_DIAG || REMOTE_SWEEP.
    - REMOTE_CUSTOM_CHAIN_DELAY 400 -> 600 ms: laisse le 1er ordre se
    terminer avant d'envoyer le "page suivante".
2026-10-18 ant remote: modules nRF52 retenus (BT832/E73-52833/E73-52832) + choix des I/O
    - §9.2: precise les variantes BT832 (seul le BT832 nu = nRF52832 ;
    BT832A/AF = nRF52810, a eviter)
    - §9.3: decision mise a jour, 3 modules dans l'ordre (BT832, E73-2G4M08S1E
    nRF52833 garde car deja en stock, E73-2G4M04S1B)
    - §9.6: estimation de cout JLCPCB (module + setup + X-ray) des candidats
    - §9.7: regles de choix des GPIO (LED high-drive hors zone radio, boutons
    sur entrees lentes), listes "proche radio" 52832/52833, plan de broches
    unifie + mapping par module
    - ajoute doc/hardware_notes.pdf (export 21 pages)
2026-10-18 ant remote: debug J1 = SWD + SWO uniquement (ETM hors scope)
    - §9.7: sous-section "Debug & trace" ; breakpoints via SWD seul (6 HW BP
    + 4 watchpoints), trace limitee au SWO (ITM/printf) sur P0.18 (nRF52832)
    - brochage J1 a 5 signaux (SWDIO/SWDCLK/GND/VDD-sense/SWO) ; RTT sur SWD
    conseille pour le log ; ETM/trace parallele explicitement ecarte
    - P0.18 (BT832 pin castellee 12) reserve au SWO au lieu de spare/LED
    - §2: renvoi vers le brochage J1 complet
    - PDF regenere
2026-10-20 ant remote: boutons 4-5mm (tact scelle THT), retrait MDBT50Q, check Raytac JLCPCB
    - §5: actuateur reduit a ~4-5mm (decision) => nouveau choix primaire =
    tact switch scelle IP67 THT 6x6mm (Omron B3W-AQ, ~5mm de stack au lieu
    de ~12.5mm) ; alternatives E-Switch TL6059, Multicomp MPTSHW ; Multimec
    5G + cap retrograde en repli "grande cible". Corrige l'ancienne
    affirmation "pas de petit switch scelle THT"
    - §6: compare la membrane au nouveau tact ~5mm
    - §9.2/§9.3/§9.5: retire la Raytac MDBT50Q (nRF52840 hot-air) et clarifie
    que seule la MDBT50Q-512K (nRF52833) est dans la lib JLCPCB, non
    utilisable ANT => aucune Raytac 52832/52840 chez JLCPCB
    - PDF regenere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
2026-10-20 ant remote: generalise les refs "module E73" en "module" (choix non arrete)
    Le design ne depend plus d'un module precis : remplace les references
    generiques au "E73 module"/"Ebyte module" par "module" (§1 PCB, §4 holder,
    §5 THT, §9.3 footprint). Les mentions E73 restantes sont dans §9 ou elles
    comparent explicitement des modules nommes.
2026-10-20 specs/board: generalise le module nRF52 (choix non arrete, plus "E73")
    Le design cible la puce nRF52832 mais le module n'est pas fixe (shortlist
    en hardware_notes §9). Remplace les references au "module E73-2G4M08S1E"
    par un module nRF52832 generique (TBD) dans:
    - gopro_garmin_remote_specs.md (MCU/radio, PCB, BOM U1+PCB, ANT, open point 52840)
    - hardware/board/README.md (footprint/symbole places en placeholders nommes
    d'apres l'ancien gabarit E73, pinout/footprint a refaire au choix du module)
    Le schema KiCad garde le nom de symbole "E73-2G4M08S1E" (placeholder a
    remplacer dans l'editeur au choix du module, cf README). main.c inchange
    (ne cite que la puce, pas le module).
    Co-Authored-By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
